NicoAvedano/BluePill-System-TDIII/KiCad/Vista3D.JPG

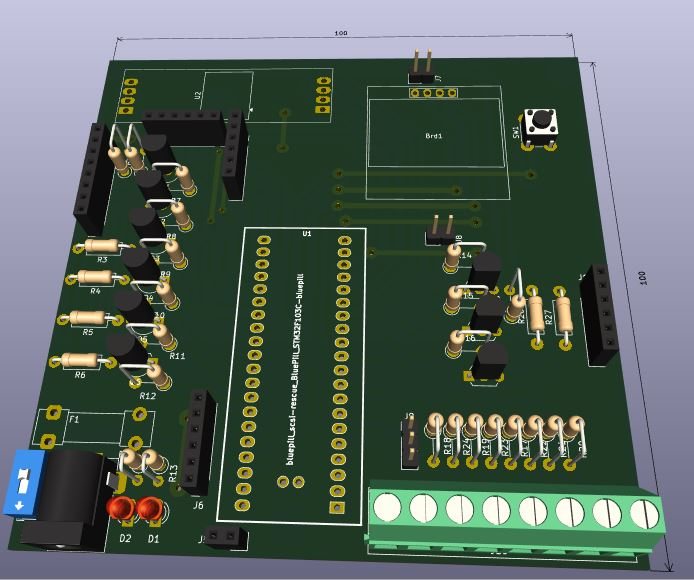
KiCad/Vista3D.JPG
