NicoAvedano/BluePill-System-TDIII/KiCad/PCB3.jpg

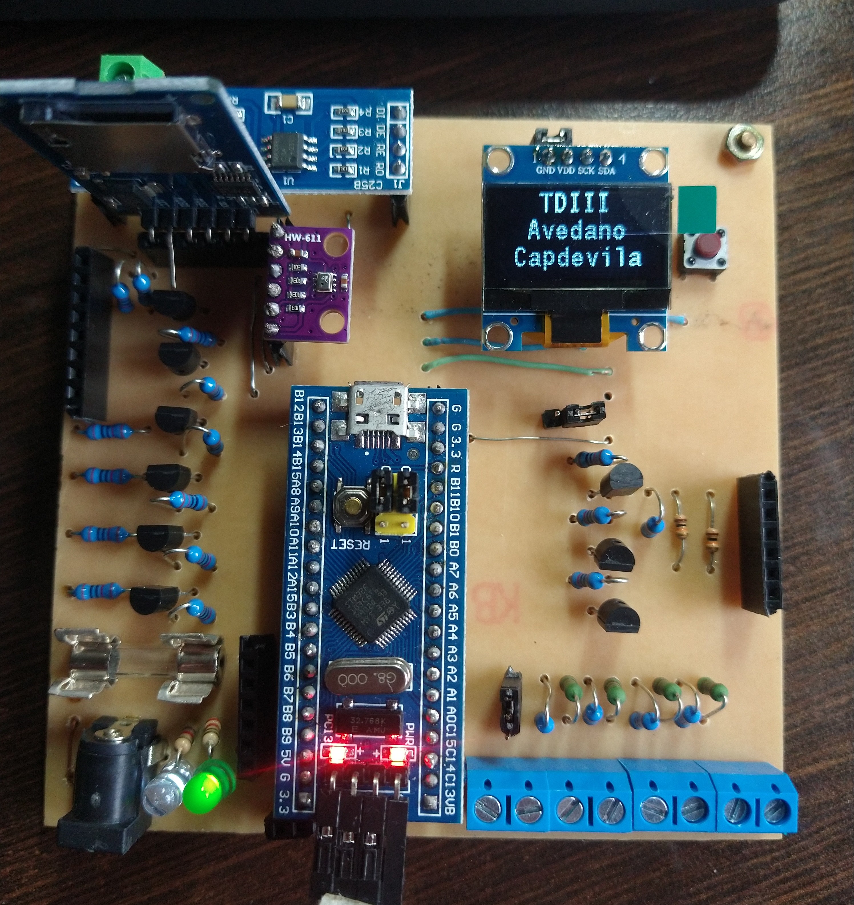
KiCad/PCB3.jpg
