NicoAvedano/BluePill-System-TDIII/KiCad/BluePillBoard.kicad_pcb

## KiCad design KiCad/BluePillBoard.kicad_pcb (2025-06-05)

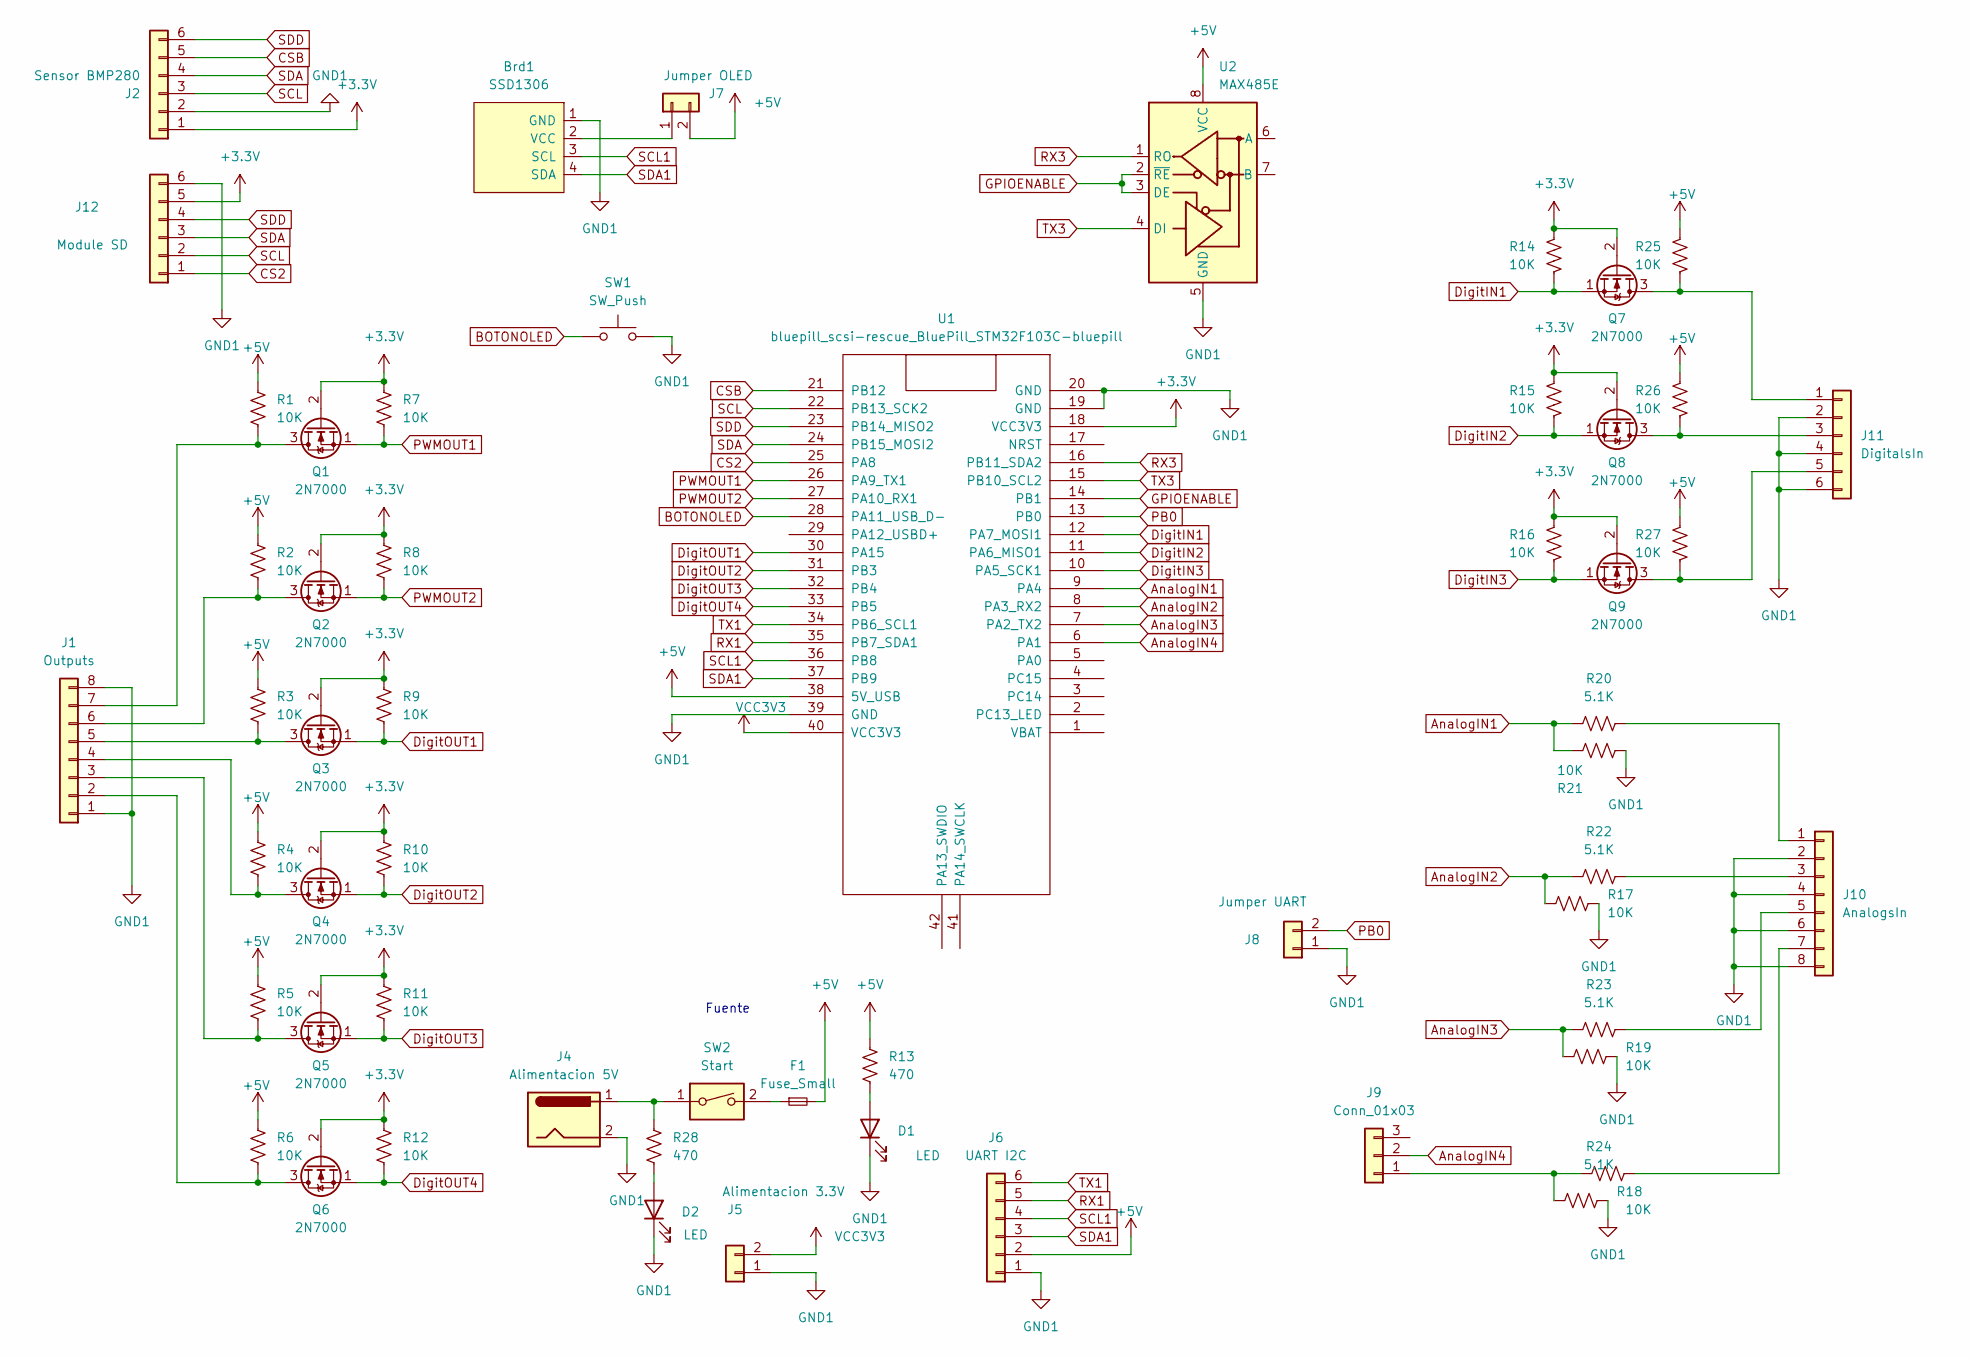
[picture p3: schematic BluePillBoard.kicad_sch]

Parts:
Brd1: SSD1306; 128x64OLED
D1, D2: LED; LED_D3.0mm
F1: Fuse_Small; Fuseholder_Clip-5x20mm_Schurter_OG_Lateral_P15.00x5.00mm_D1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
J1: Outputs; PinSocket_1x08_P2.54mm_Vertical
J2: Sensor BMP280; PinSocket_1x06_P2.54mm_Vertical
J4: Alimentacion 5V; BarrelJack_Horizontal
J5: Alimentacion 3.3V; PinSocket_1x02_P2.54mm_Vertical
J6: UART I2C; PinSocket_1x06_P2.54mm_Vertical
J7: Jumper OLED; PinHeader_1x02_P2.54mm_Vertical
J8: Jumper UART; PinHeader_1x02_P2.54mm_Vertical
J9: Conn_01x03; PinHeader_1x03_P2.54mm_Vertical
J10: AnalogsIn; TerminalBlock_Phoenix_MKDS-1,5-8-5.08_1x08_P5.08mm_Horizont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
J11: DigitalsIn; PinSocket_1x06_P2.54mm_Vertical
J12: Module SD; PinSocket_1x06_P2.54mm_Vertical
Q1, Q2, Q3, Q4, Q5, Q6, Q7, Q8, Q9: 2N7000; TO-92L_Inline_Wide
R1, R2, R7, R8, R9, R10, R11, R12, R14, R15, R16, R17, R18, R19, R21, R25: 10K; R_Axial_DIN0207_L6.3mm_D2.5mm_P5.08mm_Vertical
R3, R4, R5, R6, R26, R27: 10K; R_Axial_DIN0207_L6.3mm_D2.5mm_P10.16mm_Horizontal
R13, R28: 470; R_Axial_DIN0207_L6.3mm_D2.5mm_P2.54mm_Vertical
R20, R22, R23, R24: 5.1K; R_Axial_DIN0207_L6.3mm_D2.5mm_P5.08mm_Vertical
SW1: SW_Push; SW_PUSH_6mm_H5mm
SW2: Start; SW_DIP_SPSTx01_Slide_9.78x4.72mm_W7.62mm_P2.54mm
U1: bluepill_scsi-rescue_BluePill_STM32F103C-bluepill; BluePill_STM32F103C
U2: MAX485E; TerminalBlock_Phoenix_PTSM-0,5-4-2.5-H-THR_1x04_P2.50mm_Hor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

Connections:
+3.3V: J2.1, J12.5, Q1.2 (G), Q2.2 (G), Q3.2 (G), Q4.2 (G), Q5.2 (G), Q6.2 (G), Q7.2 (G), Q8.2 (G), Q9.2 (G), R7.2, R8.2, R9.2, R10.2, R11.2, R12.2, R14.2, R15.2, R16.2, U1.18 (VCC3V3)
+5V: F1.2, J6.2, J7.2, R1.2, R2.2, R3.2, R4.2, R5.2, R6.2, R13.1, R25.2, R26.2, R27.2, U1.38 (5V_USB), U2.8 (VCC)
AnalogIN1: R20.1, R21.2, U1.9 (PA4)
AnalogIN2: R17.1, R22.1, U1.8 (PA3_RX2)
AnalogIN3: R19.1, R23.1, U1.7 (PA2_TX2)
AnalogIN4: J9.2, U1.6 (PA1)
BOTONOLED: SW1.1, U1.28 (PA11_USB_D-)
CS2: J12.1, U1.25 (PA8)
CSB: J2.5, U1.21 (PB12)
DigitIN1: Q7.1 (S), R14.1, U1.12 (PA7_MOSI1)
DigitIN2: Q8.1 (S), R15.1, U1.11 (PA6_MISO1)
DigitIN3: Q9.1 (S), R16.1, U1.10 (PA5_SCK1)
DigitOUT1: Q3.1 (S), R9.1, U1.30 (PA15)
DigitOUT2: Q4.1 (S), R10.1, U1.31 (PB3)
DigitOUT3: Q5.1 (S), R11.1, U1.32 (PB4)
DigitOUT4: Q6.1 (S), R12.1, U1.33 (PB5)
GND1: Brd1.1 (GND), D1.1 (K), D2.1 (K), J1.1, J1.8, J2.2, J4.2, J5.1, J6.1, J8.1, J10.2, J10.4, J10.6, J10.8, J11.2, J11.4, J11.6, J12.6, R17.2, R18.2, R19.2, R21.1, SW1.2, U1.19 (GND), U1.20 (GND), U1.39 (GND), U2.5 (GND)
GPIOENABLE: U1.14 (PB1), U2.2 (~RE), U2.3 (DE)
unnamed: Brd1.2 (VCC), J7.1
unnamed: D1.2 (A), R13.2
unnamed: D2.2 (A), R28.2
unnamed: F1.1, SW2.2
unnamed: J1.2, Q6.3 (D), R6.1
unnamed: J1.3, Q5.3 (D), R5.1
unnamed: J1.4, Q4.3 (D), R4.1
unnamed: J1.5, Q3.3 (D), R3.1
unnamed: J1.6, Q2.3 (D), R2.1
unnamed: J1.7, Q1.3 (D), R1.1
unnamed: J4.1, R28.1, SW2.1
unnamed: J9.1, R18.1, R24.1
unnamed: J10.1, R20.2
unnamed: J10.3, R22.2
unnamed: J10.5, R23.2
unnamed: J10.7, R24.2
unnamed: J11.1, Q7.3 (D), R25.1
unnamed: J11.3, Q8.3 (D), R26.1
unnamed: J11.5, Q9.3 (D), R27.1
PB0: J8.2, U1.13 (PB0)
PWMOUT1: Q1.1 (S), R7.1, U1.26 (PA9_TX1)
PWMOUT2: Q2.1 (S), R8.1, U1.27 (PA10_RX1)
RX1: J6.5, U1.35 (PB7_SDA1)
RX3: U1.16 (PB11_SDA2), U2.1 (RO)
SCL: J2.3, J12.2, U1.22 (PB13_SCK2)
SCL1: Brd1.3 (SCL), J6.4, U1.36 (PB8)
SDA: J2.4, J12.3, U1.24 (PB15_MOSI2)
SDA1: Brd1.4 (SDA), J6.3, U1.37 (PB9)
SDD: J2.6, J12.4, U1.23 (PB14_MISO2)
TX1: J6.6, U1.34 (PB6_SCL1)
TX3: U1.15 (PB10_SCL2), U2.4 (DI)
VCC3V3: J5.2, U1.40 (VCC3V3)

Notes on the sheet:
Fuente

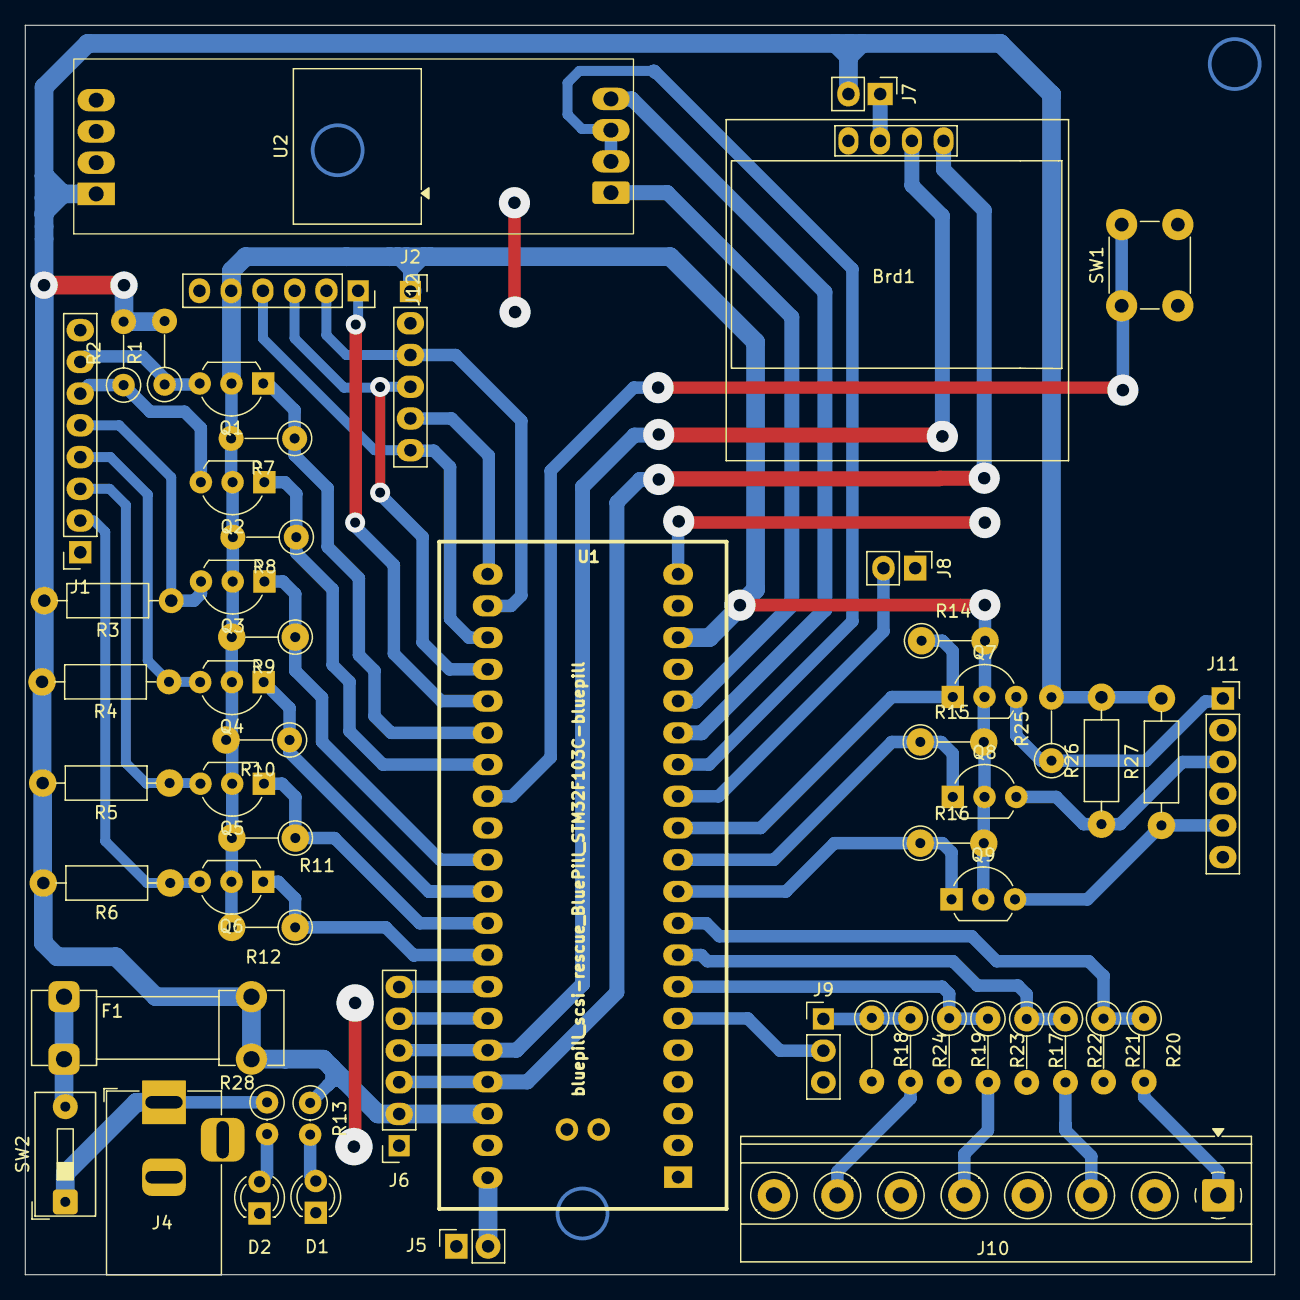
[picture p4: board BluePillBoard.kicad_pcb from above]

Board: 2 copper layers, 100.0 x 100.0 mm, 56 parts (0 on the bottom side), 50 nets.
